pigatron-industries/xen_algorhythm/README.md

# AlgoRhythm

Eurorack algorithmic rhythm generator.
