pigatron-industries/xen_algorhythm/hardware/PGTN022_euclidean_logic.brd

## EAGLE design hardware/PGTN022_euclidean_logic.brd (2021-12-28)

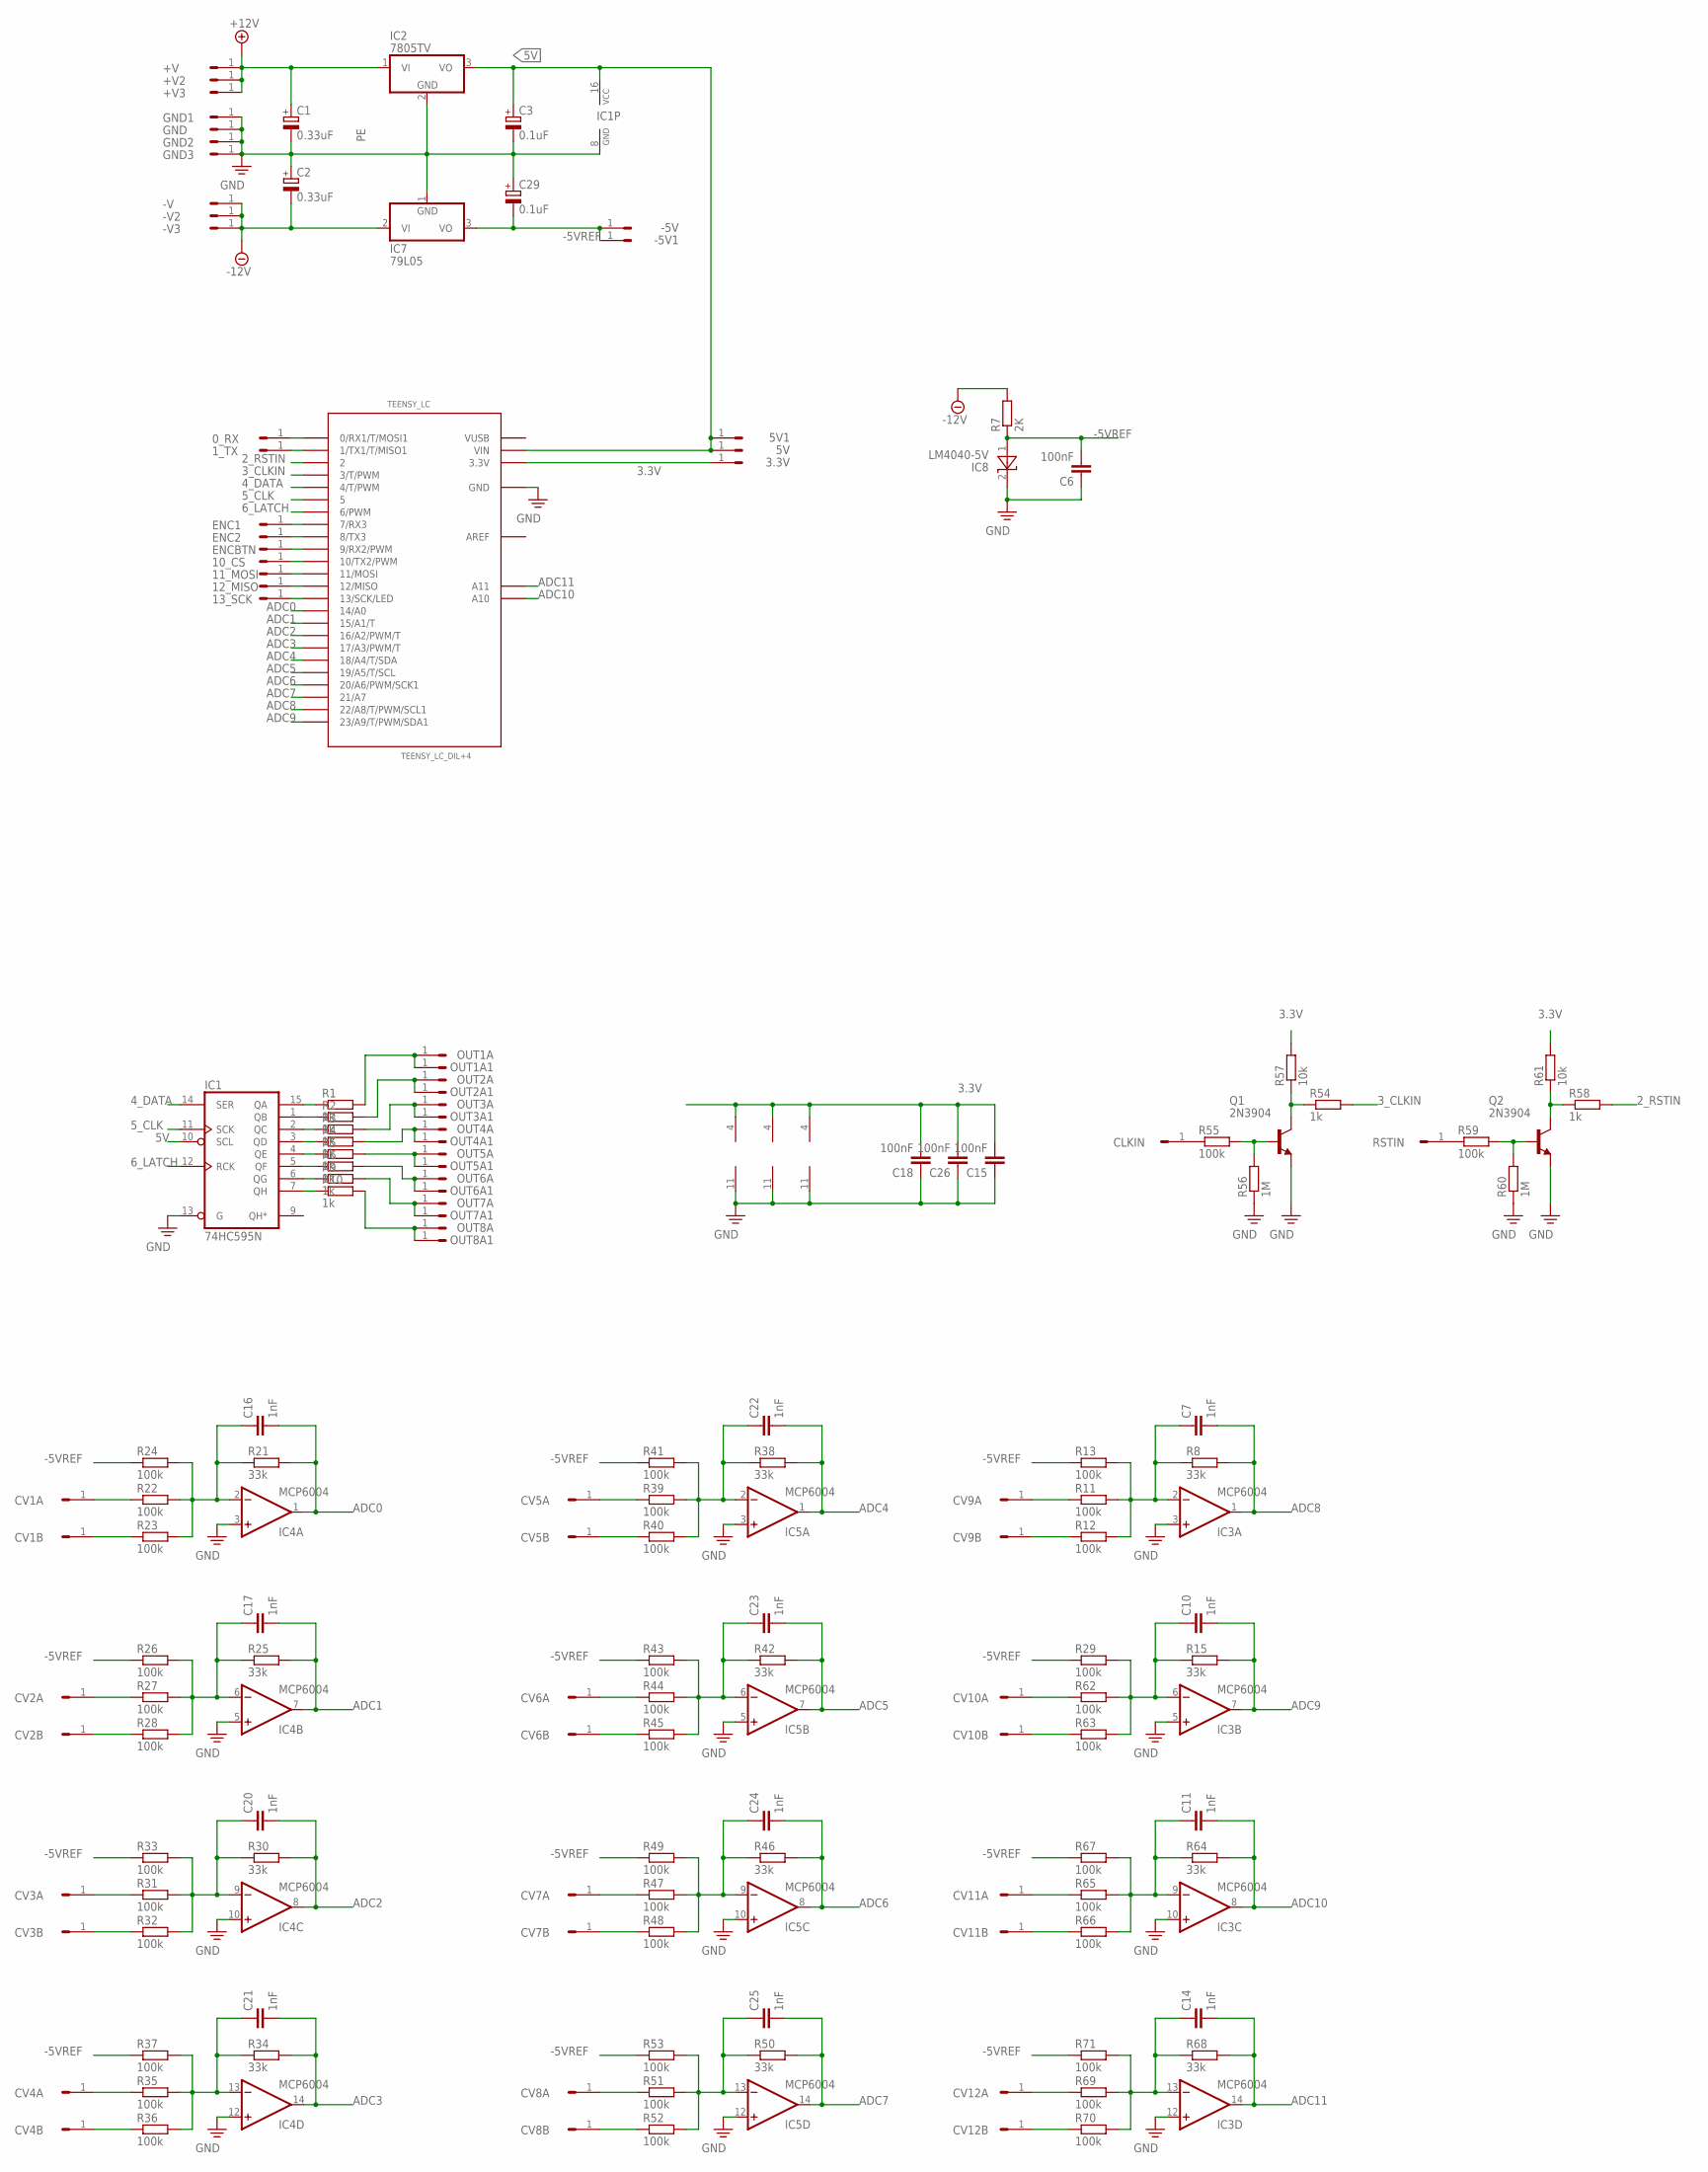
[picture p1: schematic PGTN022_euclidean_logic.sch]

Parts:
0_RX, 1_TX, 3.3V, 5V, 5V1, 10_CS, 11_MOSI, 12_MISO, 13_SCK: HEADER/MALE/01
+V, +V2, +V3: HEADER/MALE/01
-5V, -5V1: HEADER/MALE/01
-V, -V2, -V3: HEADER/MALE/01
C1, C2: 0.33uF; E2,5-6
C3, C29: 0.1uF; E2,5-6
C6, C15, C18, C26: 100nF; CERAMICDISC/5
C7, C10, C11, C14, C16, C17, C20, C21, C22, C23, C24, C25: 1nF; CERAMICDISC/5
CLKIN: HEADER/MALE/01
CV1A, CV1B, CV2A, CV2B, CV3A, CV3B, CV4A, CV4B, CV5A, CV5B, CV6A, CV6B, CV7A, CV7B, CV8A, CV8B, CV9A, CV9B, CV10A, CV10B, CV11A, CV11B, CV12A, CV12B: HEADER/MALE/01
ENC1, ENC2: HEADER/MALE/01
ENCBTN: HEADER/MALE/01
GND, GND1, GND2, GND3: HEADER/MALE/01
IC1: 74HC595N; DIL16
IC2: 7805TV; TO220V
IC3, IC4, IC5: MCP6004; DIL14
IC7: 79L05; TO92
IC8: LM4040-5V; TO92
OUT1A, OUT1A1, OUT2A, OUT2A1, OUT3A, OUT3A1, OUT4A, OUT4A1, OUT5A, OUT5A1, OUT6A, OUT6A1, OUT7A, OUT7A1, OUT8A, OUT8A1: HEADER/MALE/01
Q1, Q2: 2N3904; TO92
R1, R2, R3, R4, R5, R6, R9, R10, R54, R58: 1k; RESISTOR/7.5
R7: 2K; RESISTOR/7.5
R8, R15, R21, R25, R30, R34, R38, R42, R46, R50, R64, R68: 33k; RESISTOR/7.5
R11, R12, R13, R22, R23, R24, R26, R27, R28, R29, R31, R32, R33, R35, R36, R37, R39, R40, R41, R43, R44, R45, R47, R48, R49, R51, R52, R53, R55, R59, R62, R63, R65, R66, R67, R69, R70, R71: 100k; RESISTOR/7.5
R56, R60: 1M; RESISTOR/7.5
R57, R61: 10k; RESISTOR/7.5
RSTIN: HEADER/MALE/01
TEENSY_LC: TEENSY_LC_DIL+4; TEENSY_3.0-3.2&LC_DIL+4

Connections:
2_RSTIN: R58.2, TEENSY_LC.2
3.3V: 3.3V.1, C15.2, C18.2, C26.2, IC3.4 (V+), IC4.4 (V+), IC5.4 (V+), R57.2, R61.2, TEENSY_LC.3.3V
3_CLKIN: R54.2, TEENSY_LC.3 (3/T/PWM)
4_DATA: IC1.14 (SER), TEENSY_LC.4 (4/T/PWM)
5V: 5V.1, 5V1.1, C3.+, IC1.10 (SCL), IC1.16 (VCC), IC2.3 (VO), TEENSY_LC.VIN
5_CLK: IC1.11 (SCK), TEENSY_LC.5
6_LATCH: IC1.12 (RCK), TEENSY_LC.6 (6/PWM)
+12V: +V.1, +V2.1, +V3.1, C1.+, IC2.1 (VI)
-5VREF: -5V.1, -5V1.1, C6.2, C29.-, IC7.3 (VO), IC8.1 (A), R7.1, R13.1, R24.1, R26.1, R29.1, R33.1, R37.1, R41.1, R43.1, R49.1, R53.1, R67.1, R71.1
-12V: -V.1, -V2.1, -V3.1, C2.-, IC7.2 (VI), R7.2
ADC0: C16.2, IC4.1 (OUT), R21.2, TEENSY_LC.14/A0
ADC1: C17.2, IC4.7 (OUT), R25.2, TEENSY_LC.15/A1 (15/A1/T)
ADC2: C20.2, IC4.8 (OUT), R30.2, TEENSY_LC.16/A2 (16/A2/PWM/T)
ADC3: C21.2, IC4.14 (OUT), R34.2, TEENSY_LC.17/A3 (17/A3/PWM/T)
ADC4: C22.2, IC5.1 (OUT), R38.2, TEENSY_LC.18/A4 (18/A4/T/SDA)
ADC5: C23.2, IC5.7 (OUT), R42.2, TEENSY_LC.19/A5 (19/A5/T/SCL)
ADC6: C24.2, IC5.8 (OUT), R46.2, TEENSY_LC.20/A6 (20/A6/PWM/SCK1)
ADC7: C25.2, IC5.14 (OUT), R50.2, TEENSY_LC.21/A7
ADC8: C7.2, IC3.1 (OUT), R8.2, TEENSY_LC.22/A8 (22/A8/T/PWM/SCL1)
ADC9: C10.2, IC3.7 (OUT), R15.2, TEENSY_LC.23/A9 (23/A9/T/PWM/SDA1)
ADC10: C11.2, IC3.8 (OUT), R64.2, TEENSY_LC.A10
ADC11: C14.2, IC3.14 (OUT), R68.2, TEENSY_LC.A11
AREF: TEENSY_LC.AREF
unnamed: CV2A.1, R27.1
unnamed: IC1.15 (QA), R1.1
unnamed: OUT1A.1, OUT1A1.1, R1.2
unnamed: IC1.1 (QB), R2.1
unnamed: IC1.2 (QC), R3.1
unnamed: IC1.3 (QD), R4.1
unnamed: IC1.4 (QE), R5.1
unnamed: C7.1, IC3.2 (-IN), R8.1, R11.2, R12.2, R13.2
unnamed: IC1.5 (QF), R6.1
unnamed: IC1.6 (QG), R9.1
unnamed: IC1.7 (QH), R10.1
unnamed: OUT8A.1, OUT8A1.1, R10.2
unnamed: CV9B.1, R12.1
unnamed: CV9A.1, R11.1
unnamed: OUT2A.1, OUT2A1.1, R2.2
unnamed: C10.1, IC3.6 (-IN), R15.1, R29.2, R62.2, R63.2
unnamed: OUT3A.1, OUT3A1.1, R3.2
unnamed: CV10A.1, R62.1
unnamed: CV10B.1, R63.1
unnamed: OUT4A.1, OUT4A1.1, R4.2
unnamed: OUT5A.1, OUT5A1.1, R5.2
unnamed: CV1A.1, R22.1
unnamed: C16.1, IC4.2 (-IN), R21.1, R22.2, R23.2, R24.2
unnamed: R59.1, RSTIN.1
unnamed: CV2B.1, R28.1
unnamed: CV1B.1, R23.1
unnamed: OUT6A.1, OUT6A1.1, R6.2
unnamed: C17.1, IC4.6 (-IN), R25.1, R26.2, R27.2, R28.2
unnamed: C21.1, IC4.13 (-IN), R34.1, R35.2, R36.2, R37.2
unnamed: CV4A.1, R35.1
unnamed: CV4B.1, R36.1
unnamed: OUT7A.1, OUT7A1.1, R9.2
unnamed: CV3B.1, R32.1
unnamed: CV3A.1, R31.1
unnamed: C20.1, IC4.9 (-IN), R30.1, R31.2, R32.2, R33.2
unnamed: 12_MISO.1, TEENSY_LC.12 (12/MISO)
unnamed: C22.1, IC5.2 (-IN), R38.1, R39.2, R40.2, R41.2
unnamed: 0_RX.1, TEENSY_LC.0 (0/RX1/T/MOSI1)
unnamed: CV5B.1, R40.1
unnamed: CV5A.1, R39.1
unnamed: 1_TX.1, TEENSY_LC.1 (1/TX1/T/MISO1)
unnamed: C23.1, IC5.6 (-IN), R42.1, R43.2, R44.2, R45.2
unnamed: CV6A.1, R44.1
unnamed: CV6B.1, R45.1
unnamed: C25.1, IC5.13 (-IN), R50.1, R51.2, R52.2, R53.2
unnamed: ENC1.1, TEENSY_LC.7 (7/RX3)
unnamed: CV8A.1, R51.1
unnamed: CV8B.1, R52.1
unnamed: CV7B.1, R48.1
unnamed: CV7A.1, R47.1
unnamed: C24.1, IC5.9 (-IN), R46.1, R47.2, R48.2, R49.2
unnamed: ENC2.1, TEENSY_LC.8 (8/TX3)
unnamed: CLKIN.1, R55.1
unnamed: Q1.2 (B), R55.2, R56.2
unnamed: Q1.1 (C), R54.1, R57.1
unnamed: C14.1, IC3.13 (-IN), R68.1, R69.2, R70.2, R71.2
unnamed: Q2.2 (B), R59.2, R60.2
unnamed: Q2.1 (C), R58.1, R61.1
unnamed: CV12A.1, R69.1
unnamed: ENCBTN.1, TEENSY_LC.9 (9/RX2/PWM)
unnamed: 10_CS.1, TEENSY_LC.10 (10/TX2/PWM)
unnamed: 11_MOSI.1, TEENSY_LC.11 (11/MOSI)
unnamed: 13_SCK.1, TEENSY_LC.13 (13/SCK/LED)
unnamed: CV12B.1, R70.1
unnamed: CV11B.1, R66.1
unnamed: CV11A.1, R65.1
unnamed: C11.1, IC3.9 (-IN), R64.1, R65.2, R66.2, R67.2
PE: C1.-, C2.+, C3.-, C6.1, C15.1, C18.1, C26.1, C29.+, GND.1, GND1.1, GND2.1, GND3.1, IC1.8 (GND), IC1.13 (G), IC2.2 (GND), IC3.3 (+IN), IC3.5 (+IN), IC3.10 (+IN), IC3.11 (V-), IC3.12 (+IN), IC4.3 (+IN), IC4.5 (+IN), IC4.10 (+IN), IC4.11 (V-), IC4.12 (+IN), IC5.3 (+IN), IC5.5 (+IN), IC5.10 (+IN), IC5.11 (V-), IC5.12 (+IN), IC7.1 (GND), IC8.2 (C), Q1.3 (E), Q2.3 (E), R56.1, R60.1, TEENSY_LC.AGND (GND), TEENSY_LC.GND
VUSB: TEENSY_LC.VUSB

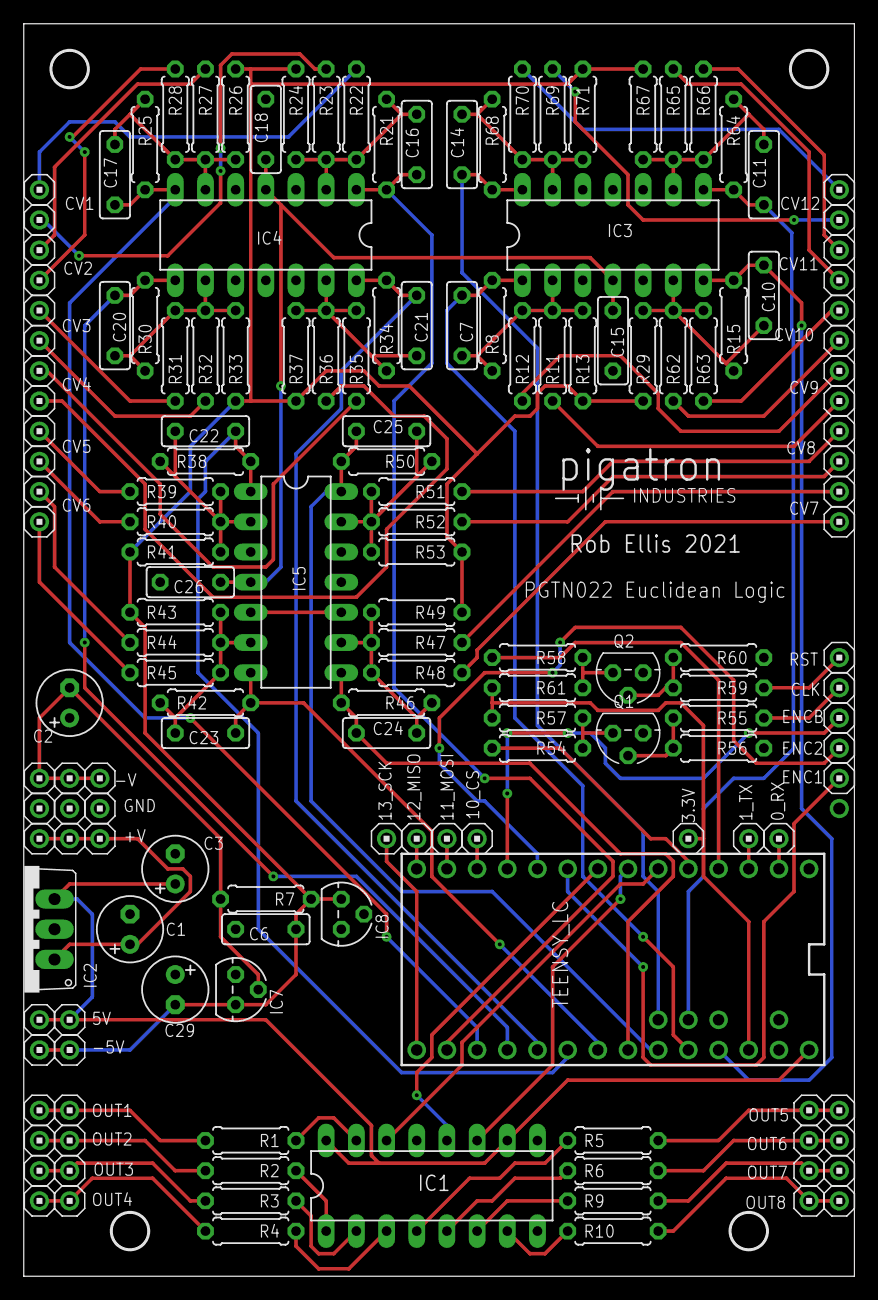
[picture p2: board PGTN022_euclidean_logic.brd from above]

Board: 2 copper layers, 69.9 x 105.4 mm, 166 parts (1 on the bottom side), 90 nets.

Other parts of the board:
U$1: PIGATRON-LOGO
U$2, U$3, U$4, U$5: STANDOFF/3.0
