pigatron-industries/xen_algorhythm/src/modules/controllers/EuclideanLogicController.cpp

#include "EuclideanLogicController.h"

void EuclideanLogicController::init() { 
}

void EuclideanLogicController::execute() {
    bool changed = false;
    for(int channel = 0; channel < CHANNELS; channel++) {
        changed |= euclideanChannels[channel].update();

        if(mode == Mode::SYNCHRONOUS) {
            euclideanChannels[channel].setFrameLength(euclideanChannels[0].getLength());
        }
    }

    if(mode == Mode::DUAL_SEQUENTIAL) {
        sequentialGenerator[0].update();
        sequentialGenerator[1].update();
    }
}

void EuclideanLogicController::setMode(Mode mode) {
    this->mode = mode;
    for(int channel = 0; channel < CHANNELS; channel++) {
        euclideanChannels[channel].setFrameMode(mode == Mode::SYNCHRONOUS ? EuclideanRhythmGenerator::FrameMode::FRAME_SINGLE : 
                                                                            EuclideanRhythmGenerator::FrameMode::FRAME_NONE);
    }
}

void EuclideanLogicController::clock() {
    switch(mode) {
        case Mode::ASYNCHRONOUS:
        case Mode::SYNCHRONOUS:
            euclideanChannels[0].clock();
            euclideanChannels[1].clock();
            euclideanChannels[2].clock();
            euclideanChannels[3].clock();
            gateOutputs.setValue(0, euclideanChannels[0].getOutput());
            gateOutputs.setValue(1, euclideanChannels[1].getOutput());
            gateOutputs.setValue(2, euclideanChannels[2].getOutput());
            gateOutputs.setValue(3, euclideanChannels[3].getOutput());
            gateOutputs.setValue(4, logicGates[0].getOutput());
            gateOutputs.setValue(5, logicGates[1].getOutput());
            gateOutputs.setValue(6, logicGates[2].getOutput());
            gateOutputs.setValue(7, logicGates[3].getOutput());
            break;
        case Mode::DUAL_SEQUENTIAL:
            sequentialGenerator[0].clock();
            sequentialGenerator[1].clock();
            gateOutputs.setValue(0, sequentialGenerator[0].getOutput());
            gateOutputs.setValue(2, sequentialGenerator[1].getOutput());
            break;
    }

    gateOutputs.sendData();
    debugClock();
}

void EuclideanLogicController::reset() {
    for(int channel = 0; channel < CHANNELS; channel++) {
        euclideanChannels[channel].reset();
    }
    clear();
    debugReset();
}

void EuclideanLogicController::clear() {
    for(int channel = 0; channel < CHANNELS+4; channel++) {
        gateOutputs.setValue(channel, false);
    }
    gateOutputs.sendData();
}

void EuclideanLogicController::debugReset() {
    Serial.print("Mode: ");
    Serial.println(mode);
    for(int channel = 0; channel < CHANNELS; channel++) {
        euclideanChannels[channel].debug();
    }
}

void EuclideanLogicController::debugClock() {
    // for(int channel = 0; channel < CHANNELS; channel++) {
    //     Serial.print(euclideanRhythmControllers[channel].getPosition());
    //     Serial.print(":");
    //     Serial.print(euclideanRhythmControllers[channel].getOutput());
    //     Serial.print(" ");
    // }
    // Serial.println();
}
