pigatron-industries/xen_algorhythm/src/modules/controllers/channel/EuclideanChannelController.cpp

#include "EuclideanChannelController.h"

EuclideanRhythmController::EuclideanRhythmController(uint8_t lengthPin, uint8_t offsetPin, uint8_t densityPin) : 
    lengthInput(lengthPin, -5, 5, 1, 17),
    densityInput(densityPin, -5, 5, 0, 1),
    offsetInput(offsetPin, -5, 5, 0, 1) {
}

void EuclideanRhythmController::update() {
    if(lengthInput.update()) {
        if(generator.setLength(lengthInput.getValue())) {
            debug();
        }
    }
    if(densityInput.update()) {
        uint8_t density = (generator.getLength()+1) * densityInput.getValue();
        if(generator.setDensity(density)) {
            debug();
        }
    }
    if(offsetInput.update()) {
        uint8_t offset = generator.getFrameLength() * offsetInput.getValue();
        if(generator.setOffset(offset)) {
            debug();
        }
    }
}

void EuclideanRhythmController::clock() {
    generator.clock();
}

void EuclideanRhythmController::reset() {
    generator.reset();
}

void EuclideanRhythmController::debug() {
    Serial.print(generator.getLength());
    Serial.print(" ");
    Serial.print(generator.getDensity());
    Serial.print(" ");
    Serial.print(generator.getOffset());
    Serial.println();

    for(int i = 0; i < generator.getFrameLength(); i++) {
        Serial.print(generator.getRhythm().getBeat(i));
    }
    Serial.println();
}
