pigatron-industries/xen_algorhythm/(commit log)

2021-04-06 Commit all code
    [PGTN022_euclidean_logic.brd, PGTN022_euclidean_logic.sch]
2021-04-07 Make encoder push button do a reset
    [MainController.cpp, MainController.h, hwconfig.h]
2021-04-10 use interrupt based trigger input to detect shorter pulses
    [MainController.cpp, MainController.h]
2021-07-22 Use template class for push button
2021-12-28 Moved main controller functions into abstract class
    [PGTN022_euclidean_logic.brd]
2022-02-09 Fix mki compile errors
    [Controller.h, DecoderController.cpp, Hardware.cpp, Hardware.h, MainController.cpp]
2022-03-16 use init and send function on device
2022-03-18 Fixed some issues with synchronous mode
    [EuclideanChannel.cpp, EuclideanLogicController.cpp, EuclideanLogicController.h]
